tshum101/KeyBard9001/README.md

# KeyBard9001
Custom Keyboard Firmware

# What is this project?

## Open in VS Code

Open `KeyBard9001.code-workspace`. Firmware (`00_DesignFiles`) and Docs stay their own folders. Repo is this directory, so `AGENTS.md`, `README.md`, and the workspace file show in the explorer. The root `CMakeLists.txt` is not the firmware build. Configure and build from `00_DesignFiles`.
