tshum101/KeyBard9001/DesignNotes.md

# Overview

## Parts
- ALEDs: 
    - SK6812MINI-E.
    - LCSC PN: [C5149201](https://www.lcsc.com/product-detail/C5149201.html?s_z=n_q_SK6812MINI-E)
- OLED I2C Screen
- Keyboard Switches
