tshum101/KeyBard9001/01_Docs/DesignNotes.md

# Overview

## Parts
- MCU: STM32F407VGT6
    - External crystal: 8 MHz
    - ARM M4
    - 1 MB Flash
    - 168 MHz
    - 192 KB SRAM
- ALEDs: 
    - SK6812MINI-E
    - LCSC PN: [C5149201](https://www.lcsc.com/product-detail/C5149201.html?s_z=n_q_SK6812MINI-E)
- OLED I2C Screen
    - I2C Address: 0x3c
    - SSD1306 [Aliexpress](https://www.aliexpress.us/item/3256805114690528.html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)
- Keyboard Switches
    - Linear Tactile Brown Dustproof, Outemu [Aliexpress](https://www.aliexpress.us/item/3256809063160008.html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)
