tshum101/KeyBard9001/01_Docs/Required Mods.docx

1. SW103 mod
  a. I messed up the push button footprint.
  b. Without this mod the reset get permanently held low
  c. Steps:
    i. Cut the red trace
    ii. Lift the GREEN leg of the switch (or clip it)
    iii. Rotate the pink resistor like indicated (new position is R22-2 to R20-1)

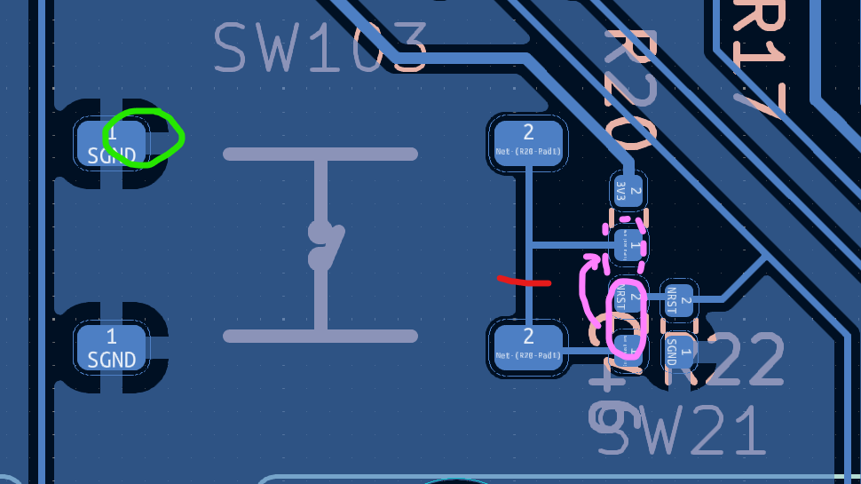
[picture p1: figure]

2. SW104 mod
  a. BTN1 to the MCU permanently held low unless this mod is applied
  b. Steps:
    i. Cut at the RED
    ii. Lift the GREEN leg of the switch (or clip it)
    iii. Rotate the pink resistor like indicated (new position is R27-2 to R25-1)

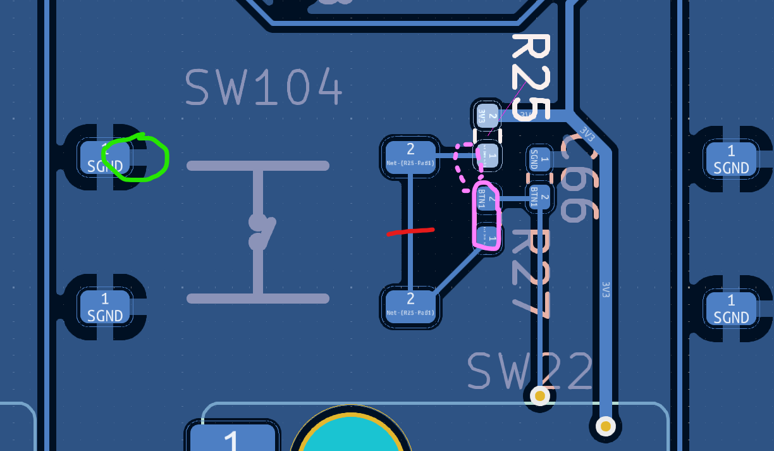
[picture p2: figure]

3. Move RGB_DATA_3V3 to SPI3 MOSI pin PC12, pin 80 on the MCU. Cut and jump.

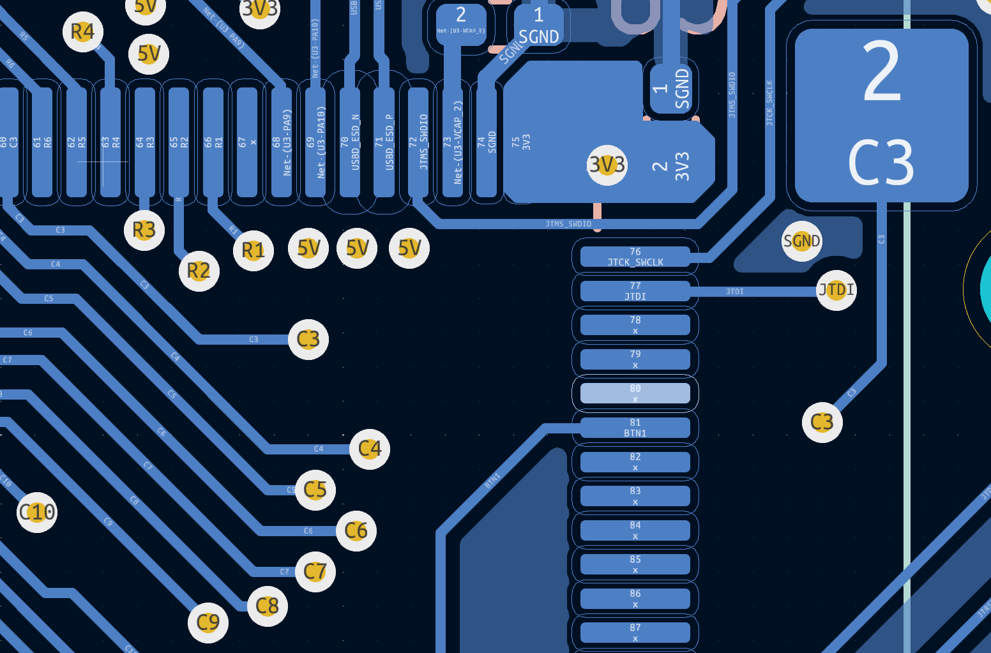
[picture p3: figure]

Pin 80

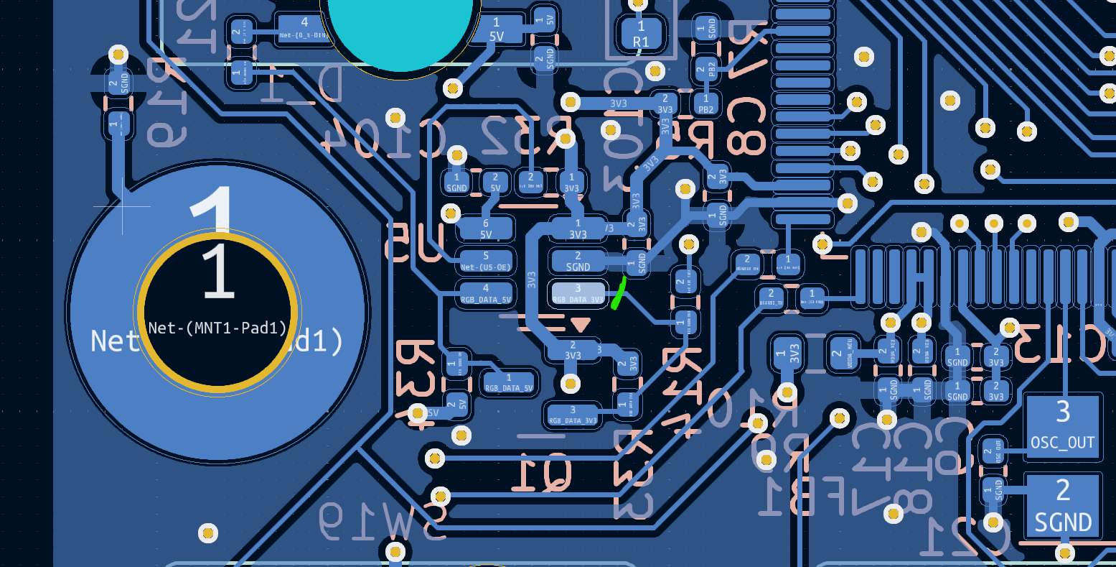
[picture p4: figure]

U5-3 (input)

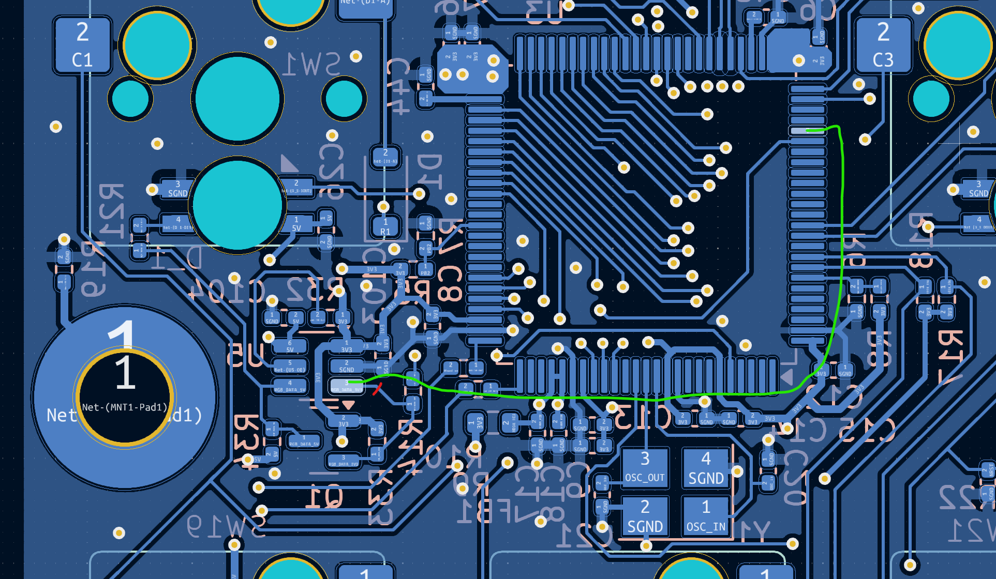
[picture p5: figure]

4. 1K Pull down on RGB_DATA_3V3
  a. Add a 1K resistor (0402) from U5-3 to U5-2

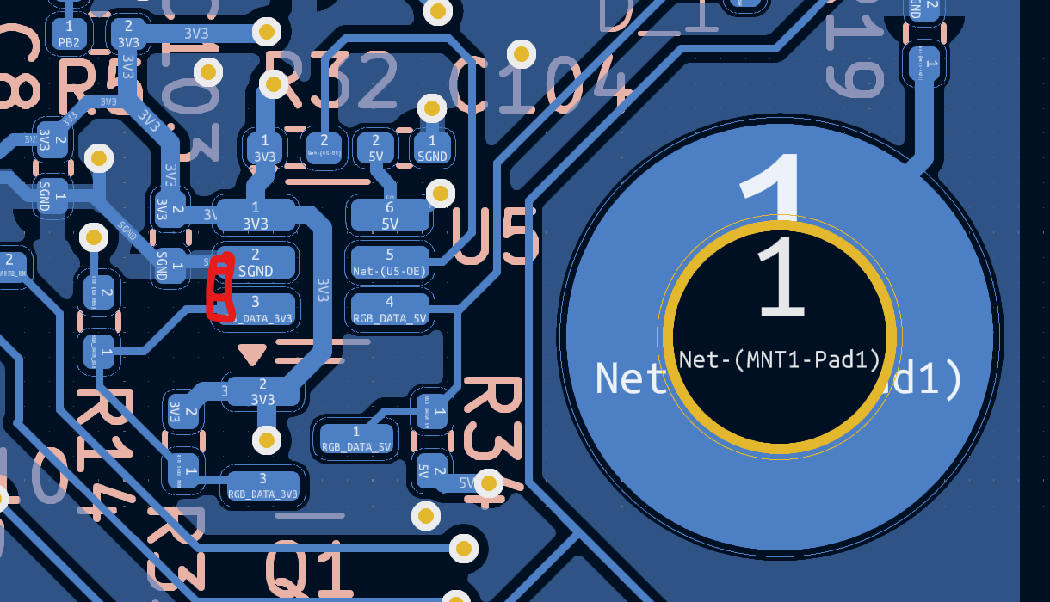
[picture p6: figure]
