tshum101/KeyBard9001/01_Docs/keyboard_layout_markedUp.png

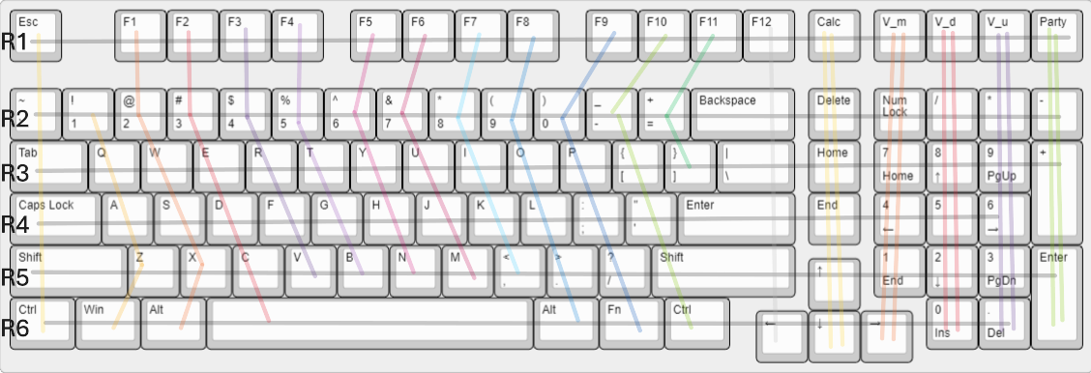
01_Docs/keyboard_layout_markedUp.png
