tshum101/KeyBard9001/01_Docs/Keybaord_Custom_1800_SCH_MODs_APPLIED.pdf

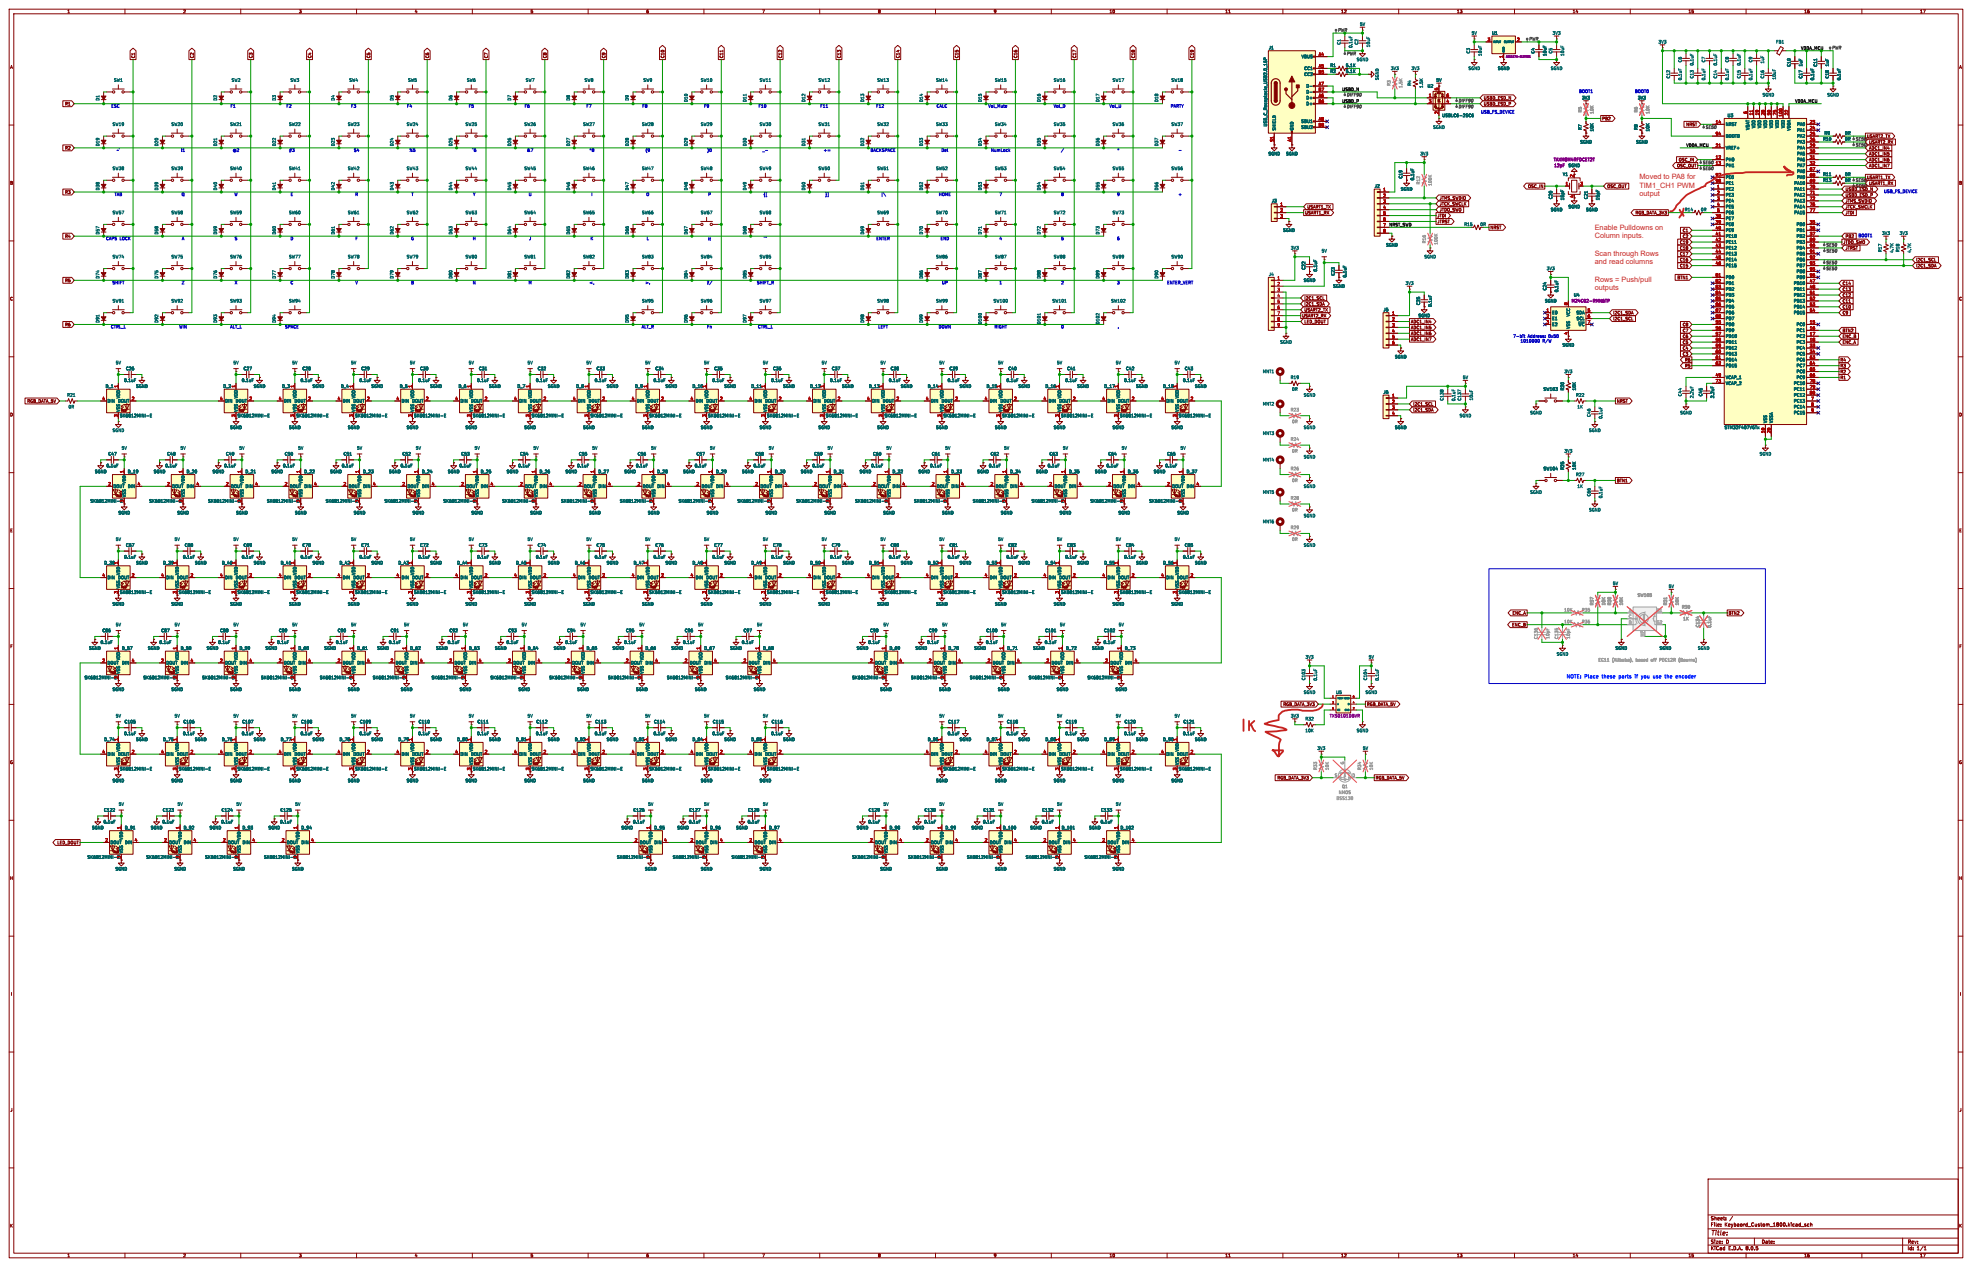
[picture p8: page 1]

3 DIN 4 SGND SGND D_46 SK6812MINI-E VDD

NOTE: Place these parts if you use the encoder

3 DIN 4 SGND D_78 SGND SGND

Id: 1/1 Title: File: Keybaord_Custom_1800.kicad_sch Sheet: /
