tshum101/KeyBard9001/00_DesignFiles/Core/Src/main.c

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
/* Includes ------------------------------------------------------------------*/
#include "main.h"
#include "usb_device.h"

/* USER CODE BEGIN Includes */
#include "button.h"
#include "dbg.h"
#include "hid_keyboard.h"
#include "led.h"
#include "matrix.h"
#include "vcp.h"
/* USER CODE END Includes */

/* USER CODE BEGIN PD */
_Static_assert(HID_KEYBOARD_REPORT_LEN == 8U, "matrix fills an 8-byte boot report");
/* USER CODE END PD */

ADC_HandleTypeDef hadc1;

I2C_HandleTypeDef hi2c1;

TIM_HandleTypeDef htim1;
TIM_HandleTypeDef htim6;
DMA_HandleTypeDef hdma_tim1_ch1;

UART_HandleTypeDef huart1;
UART_HandleTypeDef huart2;

/* USER CODE BEGIN PV */
static Button btn1 =
{
  .GPIO_PORT = BTN1_GPIO_Port,
  .GPIO_PIN = BTN1_Pin,
  .debounce_time_ms = 30U,
  .hold_time_ms = 1000U,
  .active_low = true,
};
/* USER CODE END PV */

void SystemClock_Config(void);
static void MX_GPIO_Init(void);
static void MX_DMA_Init(void);
static void MX_ADC1_Init(void);
static void MX_TIM6_Init(void);
static void MX_TIM1_Init(void);
static void MX_I2C1_Init(void);
static void MX_USART1_UART_Init(void);
static void MX_USART2_UART_Init(void);
/**
  * @brief  The application entry point.
  * @retval int
  */
int main(void)
{

  /* MCU Configuration--------------------------------------------------------*/

  /* Reset of all peripherals, Initializes the Flash interface and the Systick. */
  HAL_Init();

  /* Configure the system clock */
  SystemClock_Config();

  /* Initialize all configured peripherals */
  MX_GPIO_Init();
  MX_DMA_Init();
  MX_ADC1_Init();
  MX_TIM6_Init();
  MX_USB_DEVICE_Init();
  MX_TIM1_Init();
  MX_I2C1_Init();
  MX_USART1_UART_Init();
  MX_USART2_UART_Init();
  /* USER CODE BEGIN 2 */
  Button_Init(&btn1);
  Matrix_Init();
  Led_Init();
  if (HAL_TIM_Base_Start_IT(&htim6) != HAL_OK)
  {
    Error_Handler();
  }
  /* USER CODE END 2 */
  dbg_print_text("START PROGRAM");
  /* Infinite loop */
  /* USER CODE BEGIN WHILE */
  while (1)
  {
    /* USER CODE END WHILE */

    /* USER CODE BEGIN 3 */
    Button_Update(&btn1);
    if (btn1.pressed_flag)
    {
      btn1.pressed_flag = false;
      dbg_print_text("PRESSED yes");
    }
    if (btn1.released_flag)
    {
      btn1.released_flag = false;
      dbg_print_text("RELEASED");
    }
    if (btn1.held_flag)
    {
      btn1.held_flag = false;
      dbg_print_text("HELD");
    }
    Matrix_Poll();
    {
      uint8_t report[HID_KEYBOARD_REPORT_LEN];
      uint8_t consumer[HID_CONSUMER_REPORT_LEN];

      Matrix_FillReport(report);
      Matrix_FillConsumer(consumer);
      HidKeyboard_SendIfChanged(report);
      HidKeyboard_SendConsumerIfChanged(consumer);
      Vcp_Poll();
      Led_Poll();
    }
  }
  /* USER CODE END 3 */
}

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
/* USER CODE BEGIN 4 */
void HAL_TIM_PeriodElapsedCallback(TIM_HandleTypeDef *htim)
{
  if (htim->Instance == TIM6)
  {
    Matrix_OnTick();
  }
}
/* USER CODE END 4 */
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
