tshum101/KeyBard9001/(commit log)

2026-10-03 Refactor code structure for improved readability and maintainability
    [Keybaord_Custom_1800_BOM.csv]
2026-10-04 Add SSD1306 I2C screen details to DesignNotes.md
2026-10-08 Add USB device configuration and CMake support for STM32F407xx
    - Created usbd_conf.h for USB device configuration.
    - Added CMake toolchain files for GCC and Clang.
    - Implemented CMakeLists.txt for STM32CubeMX generated sources.
    - Included startup assembly file for STM32F407xx with vector table and handlers.
    - Configured application sources and linked necessary libraries for USB device functionality.
2026-10-10 Add new index files for USB device library headers and source files
    - Created index for usbd_hid.h to provide function and variable references.
    - Created index for usbd_ioreq.c with detailed function documentation.
    - Created index for usbd_ioreq.h to outline exported functions and types.
    - Added a JSON reply file for CMake API with configuration details and object metadata.
2026-10-12 Add button handling and debugging functionality
    - Introduced a new Button module with initialization and update functions to handle button states, including debouncing and hold detection.
    - Added a debugging utility for formatted printing of strings and integers over UART.
    - Updated AGENTS.md to clarify the structure for adding new source files in the App directory.
    - Created new header and source files for button handling and debugging.
    - Generated new build configuration files for the updated project structure.
2026-10-12 Add button state handling and update USB device configuration
2026-10-13 Update .gitignore, remove obsolete CMake API response file, and add launch configuration for STM32Cube
2026-10-13 Enhance VS Code support and project structure
    - Updated AGENTS.md to clarify workspace setup in VS Code for STM32Cube.
    - Modified README.md to include instructions for opening the project in VS Code.
    - Added .clangd configuration for compile flags.
    - Created .gitignore to exclude build artifacts and temporary files.
    - Introduced .settings files for managing IDE configurations and dependencies.
    - Added VS Code configuration files (.vscode) for C/C++ properties, extensions, launch settings, and general settings.
    - Created KeyBard9001.code-workspace to define workspace structure for firmware and documentation.
2026-10-13 Refactor debug printing functions and update main to use new implementations
2026-10-15 Add matrix handling code for keyboard input
    - Implemented matrix scanning functionality to detect key presses.
    - Defined key mappings for a 6x19 keyboard layout, including modifiers and consumer controls.
    - Introduced debounce and hold timing for button presses.
    - Added functions for initializing the matrix, polling key states, and filling HID reports.
    - Included logging for key events (pressed, released, held) for debugging purposes.
2026-10-16 Add USB device support and CMake configuration for STM32F407xx
    - Added CMake configuration files for GCC and Clang toolchains.
    - Implemented CMakeLists.txt for STM32CubeMX generated sources and libraries.
    - Organized source files for USB device library and STM32 HAL drivers.
    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
2026-10-16 Add USB DFU programming scripts and update launch configurations for STM32F407
2026-10-17 Add LED control and VCP functionality
    - Introduced LED control with support for solid color settings, brightness adjustment, and PWM signal generation.
    - Implemented VCP (Virtual COM Port) functionality for USB communication, including command handling for switching between keyboard and COM modes.
    - Added necessary header files for LED and VCP management.
    - Updated debug message handling to reflect changes in COM port status.
    - Ensured proper memory management and synchronization for data transmission and reception.
